KubaO/esp8266-pcb/esp8266-pcb.png

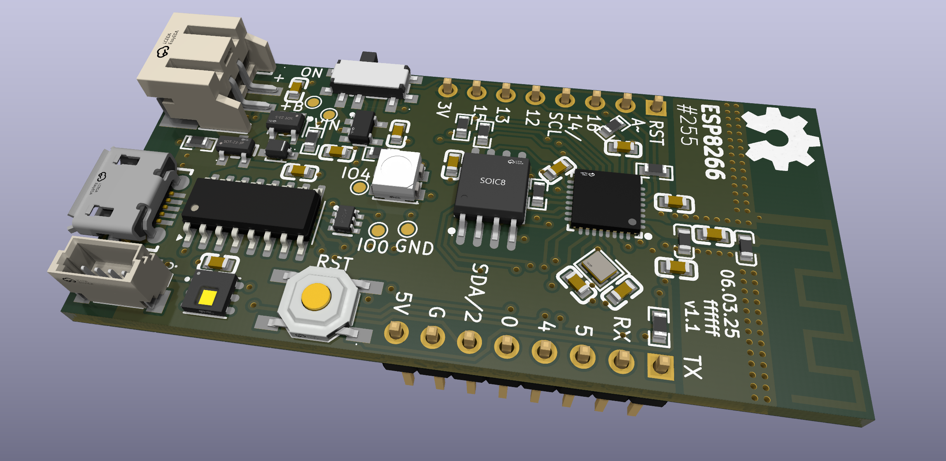
esp8266-pcb.png
