KubaO/esp8266-pcb/esp8266.kicad_pcb

## KiCad design esp8266.kicad_pcb (2025-03-06)

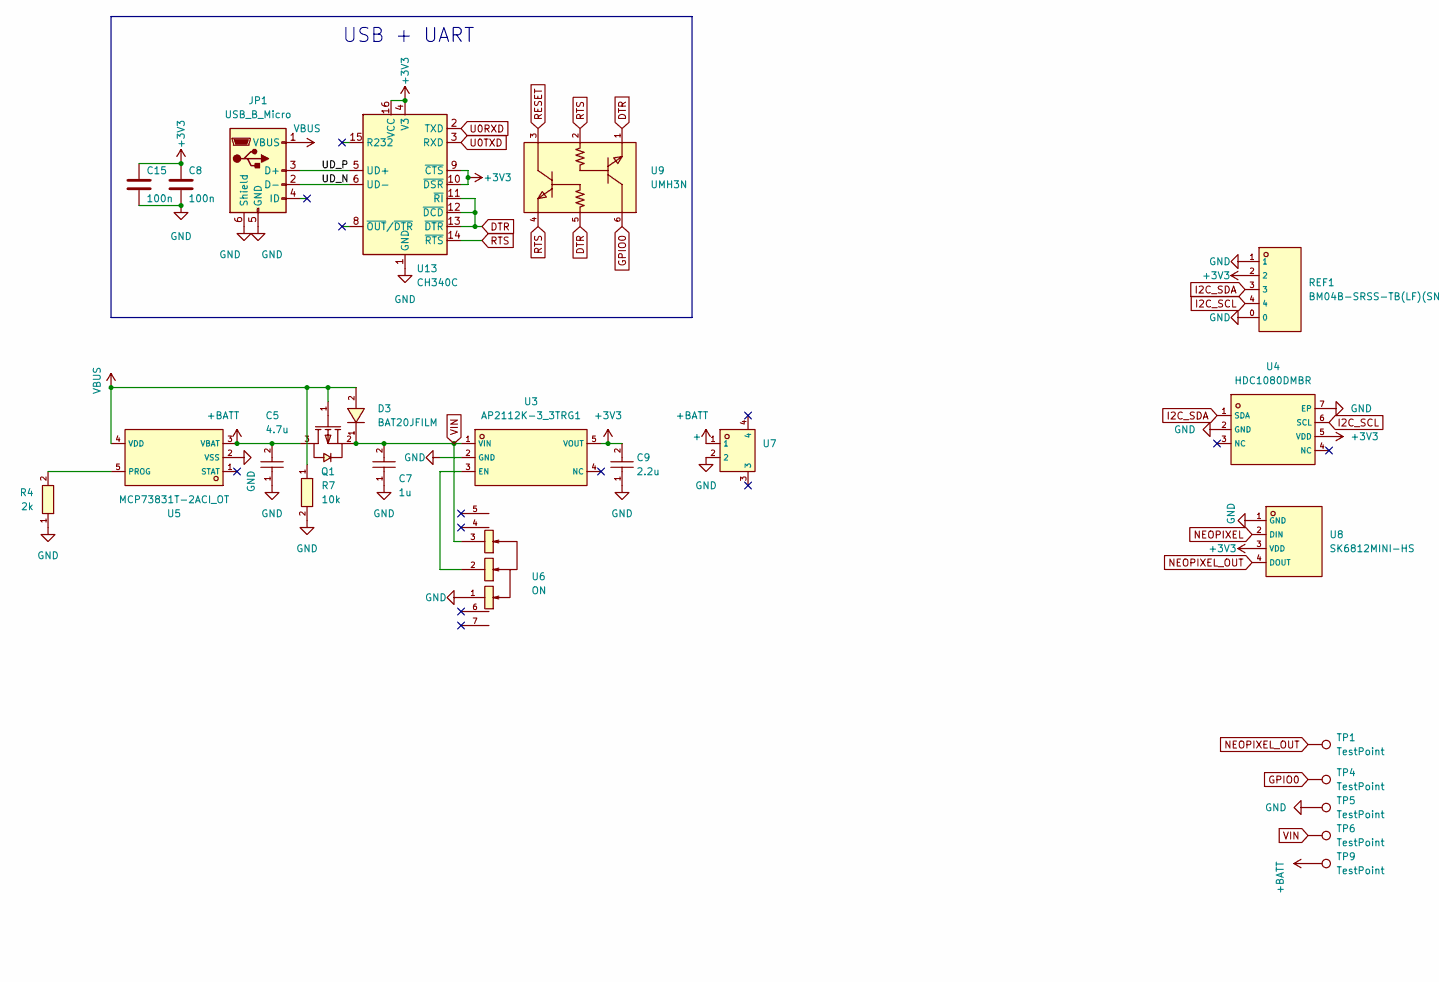
[picture p2: schematic esp8266.kicad_sch, ESP8266 Board, part in row 1, column 1]

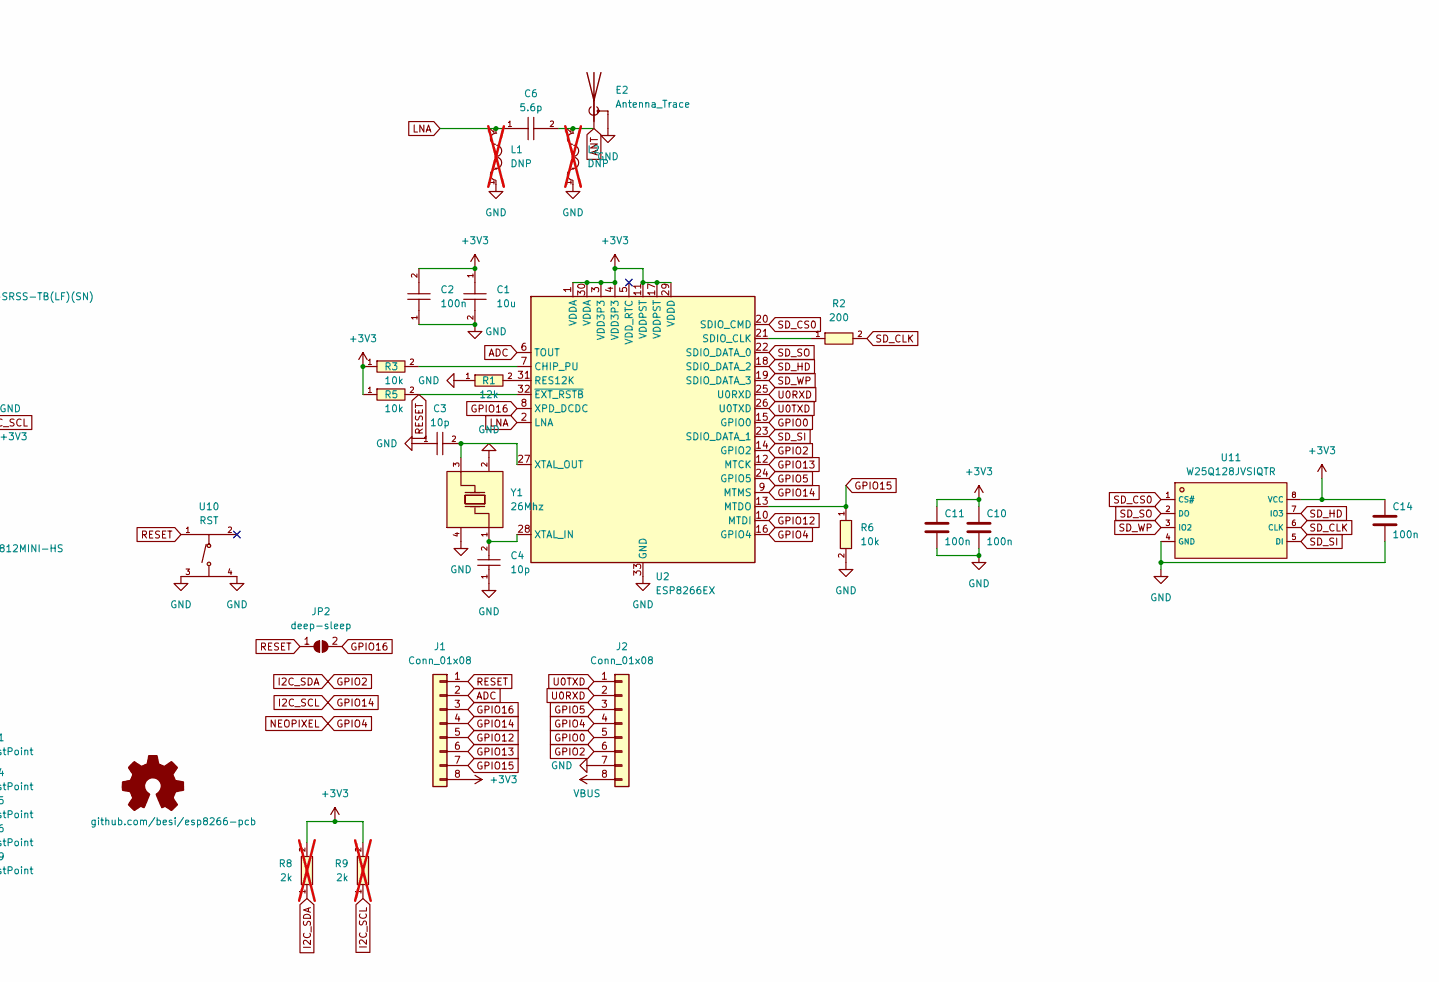
[picture p3: schematic esp8266.kicad_sch, ESP8266 Board, part in row 1, column 2]

Parts:
C1: 10u; C0603; LCSC C19702
C2, C8, C10, C11, C14, C15: 100n; C0603; LCSC C14663
C3, C4: 10p; C0603; LCSC C1634
C5: 4.7u; C0603; LCSC C19666
C6: 5.6p; C0603; LCSC C519111
C7: 1u; C0603; LCSC C15849
C9: 2.2u; C0603; LCSC C23630
D3: BAT20JFILM; SOD-323_L1.8-W1.3-LS2.5-RD; LCSC C155590
E2: Antenna_Trace; Texas_SWRA117D_2.4GHz_Right
J1, J2: Conn_01x08; PinHeader_1x08_P2.54mm_Vertical
JP1: USB_B_Micro; MICRO-USB-SMD_1050171001; LCSC C505111
JP2: deep-sleep; SolderJumper-2_P1.3mm_Open_TrianglePad1.0x1.5mm
L1, L2: DNP; L0603; LCSC C1035; not fitted
OSHW1: github.com/besi/esp8266-pcb; OSHW-Symbol_6.7x6mm_SilkScreen
Q1: AO3401A; SOT-23_L2.9-W1.3-P1.90-LS2.4-BR; LCSC C15127
R1: 12k; R0603; LCSC C22790
R2: 200; R0603; LCSC C8218
R3, R5, R6, R7: 10k; R0603; LCSC C25804
R4: 2k; R0603; LCSC C22975
R8, R9: 2k; R0603; LCSC C22975; not fitted
REF1: BM04B-SRSS-TB(LF)(SN); CONN-SMD_BM04B-SRSS-TB; LCSC C160390
TP1, TP4, TP5, TP6, TP9: TestPoint; TestPoint_Pad_D1.0mm
U2: ESP8266EX; QFN-32_L5.0-W5.0-P0.50-BL-EP3.7
U3: AP2112K-3_3TRG1; SOT-25-5_L2.9-W1.6-P0.95-LS2.8-BL; LCSC C51118
U4: HDC1080DMBR; SENSOR-SMD_HDC1080DMBR; LCSC C82227
U5: MCP73831T-2ACI_OT; SOT-23-5_L3.0-W1.7-P0.95-LS2.8-BL; LCSC C424093
U6: ON; SW-SMD_MK-12C02-G020; LCSC C963206
U7: +; CONN-SMD_P2.00_S2B-PH-SM4-TB-LF-SN; LCSC C295747
U8: SK6812MINI-HS; LED-SMD_4P-L3.5-W3.5-BR_SK6812MINI-HS; LCSC C2922787
U9: UMH3N; SC-70-6_L2.2-W1.3-P0.65-LS2.1-BR; LCSC C62892
U10: RST; SW-SMD_4P-L5.1-W5.1-P3.70-LS6.5-TL-2; LCSC C318884
U11: W25Q128JVSIQTR; SOIC-8_L5.3-W5.3-P1.27-LS8.0-BL; LCSC C97521
U13: CH340C; SOIC-16_3.9x9.9mm_P1.27mm; LCSC C7464026
Y1: 26Mhz; CRYSTAL-SMD_4P-L2.0-W1.6-BL; LCSC C255886

Connections:
+3V3: C1.1, C2.2, C8.2, C9.2, C10.2, C11.2, C14.2, C15.2, J1.8, R3.1, R5.1, R8.2, R9.2, REF1.2, U2.1 (VDDA), U2.3 (VDD3P3), U2.4 (VDD3P3), U2.11 (VDDPST), U2.17 (VDDPST), U2.29 (VDDD), U2.30 (VDDA), U3.5 (VOUT), U4.5 (VDD), U8.3 (VDD), U11.8 (VCC), U13.4 (V3), U13.9 (~CTS), U13.10 (~DSR), U13.16 (VCC)
+BATT: C5.2, Q1.3 (D), TP9.1, U5.3 (VBAT), U7.1
/UD_N: JP1.2 (D-), U13.6 (UD-)
/UD_P: JP1.3 (D+), U13.5 (UD+)
ADC: J1.2, U2.6 (TOUT)
ANT: C6.2, E2.1 (A), L2.2
DTR: U9.1 (E), U9.5 (B), U13.11 (~RI), U13.12 (~DCD), U13.13 (~DTR)
GND: C1.2, C2.1, C3.1, C4.1, C5.1, C7.1, C8.1, C9.1, C10.1, C11.1, C14.1, C15.1, E2.2 (Shield), J2.7, JP1.5 (GND), JP1.6 (Shield), L1.1, L2.1, R1.1, R4.1, R6.2, R7.2, REF1.0, REF1.1, TP5.1, U2.33 (GND), U3.2 (GND), U4.2 (GND), U4.7 (EP), U5.2 (VSS), U6.1, U7.2, U8.1 (GND), U10.3 (C), U10.4 (D), U11.4 (GND), U13.1 (GND), Y1.2 (GND), Y1.4 (GND)
GPIO0: J2.5, TP4.1, U2.15 (GPIO0), U9.6 (C)
GPIO2: J2.6, R8.1, REF1.3, U2.14 (GPIO2), U4.1 (SDA)
GPIO4: J2.4, U2.16 (GPIO4), U8.2 (DIN)
GPIO5: J2.3, U2.24 (GPIO5)
GPIO12: J1.5, U2.10 (MTDI)
GPIO13: J1.6, U2.12 (MTCK)
GPIO14: J1.4, R9.1, REF1.4, U2.9 (MTMS), U4.6 (SCL)
GPIO15: J1.7, R6.1, U2.13 (MTDO)
GPIO16: J1.3, JP2.2 (B), U2.8 (XPD_DCDC)
LNA: C6.1, L1.2, U2.2 (LNA)
NEOPIXEL_OUT: TP1.1, U8.4 (DOUT)
unnamed: R3.2, U2.7 (CHIP_PU)
unnamed: R1.2, U2.31 (RES12K)
unnamed: R2.1, U2.21 (SDIO_CLK)
unnamed: C4.2, U2.28 (XTAL_IN), Y1.1 (OSC1)
unnamed: C3.2, U2.27 (XTAL_OUT), Y1.3 (OSC2)
unnamed: U3.3 (EN), U6.2
unnamed: R4.2, U5.5 (PROG)
RESET: J1.1, JP2.1 (A), R5.2, U2.32 (~EXT_RSTB), U9.3 (C), U10.1 (A)
RTS: U9.2 (B), U9.4 (E), U13.14 (~RTS)
SD_CLK: R2.2, U11.6 (CLK)
SD_CS0: U2.20 (SDIO_CMD), U11.1 (CS#)
SD_HD: U2.18 (SDIO_DATA_2), U11.7 (IO3)
SD_SI: U2.23 (SDIO_DATA_1), U11.5 (DI)
SD_SO: U2.22 (SDIO_DATA_0), U11.2 (DO)
SD_WP: U2.19 (SDIO_DATA_3), U11.3 (IO2)
U0RXD: J2.2, U2.25 (U0RXD), U13.2 (TXD)
U0TXD: J2.1, U2.26 (U0TXD), U13.3 (RXD)
VBUS: D3.2 (A), J2.8, JP1.1 (VBUS), Q1.1 (G), R7.1, U5.4 (VDD)
VIN: C7.2, D3.1 (K), Q1.2 (S), TP6.1, U3.1 (VIN), U6.3

Notes on the sheet:
USB + UART

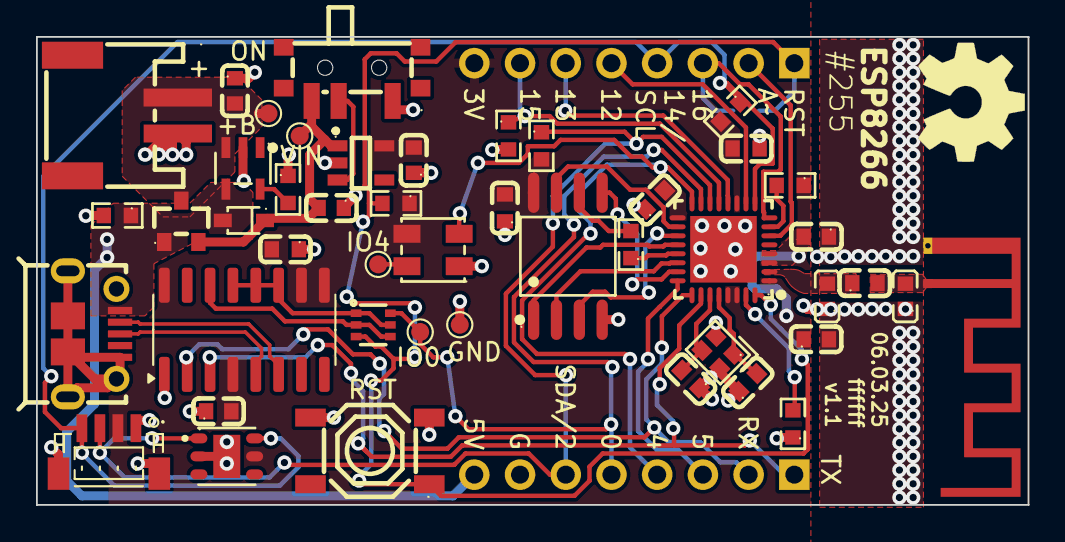
[picture p4: board esp8266.kicad_pcb from above]

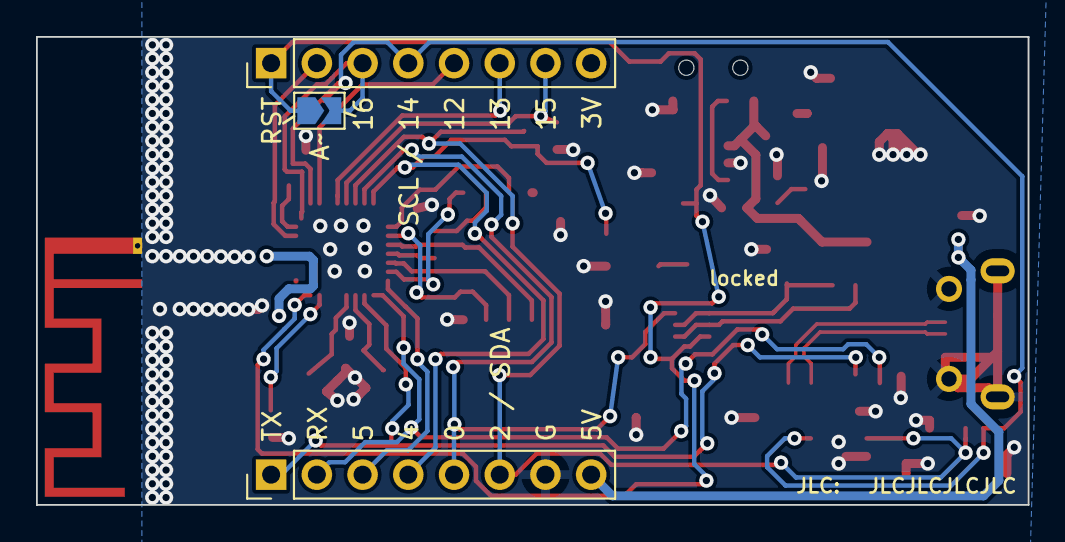
[picture p5: board esp8266.kicad_pcb from below]

Board: 2 copper layers, 55.1 x 26.0 mm, 50 parts (3 on the bottom side), 38 nets.
