KubaO/esp8266-pcb/(commit log)

2025-03-06 Fix 3D model positioning and paths.
    [esp8266.kicad_pcb]
2025-03-06 Rework layout to retain power and ground plane continuity.
    Add one more decoupling capacitor to CH340.
    The ground plane now has islands of shorter traces. The 3.3V plane has been carefully adjusted to provide reasonable impedances to all loads.
    [esp8266.kicad_pcb, esp8266.kicad_sch]
